ArthurPalladino/gigante-de-mdf/README.md

# gigante-de-mdf
O projeto gigante de MDF é um carrinho de batalha equipado com um laser como arma, capaz de detectar dano através de um LDR. Todo o sistema foi desenvolvido em C, utilizando um microcontrolador ATmega328P para controlar as funções do carrinho.
