ArthurPalladino/gigante-de-mdf/gigantes_mdf_pcb/gigantes_mdf.kicad_pcb

## KiCad design gigantes_mdf_pcb/gigantes_mdf.kicad_pcb (2025-11-25)

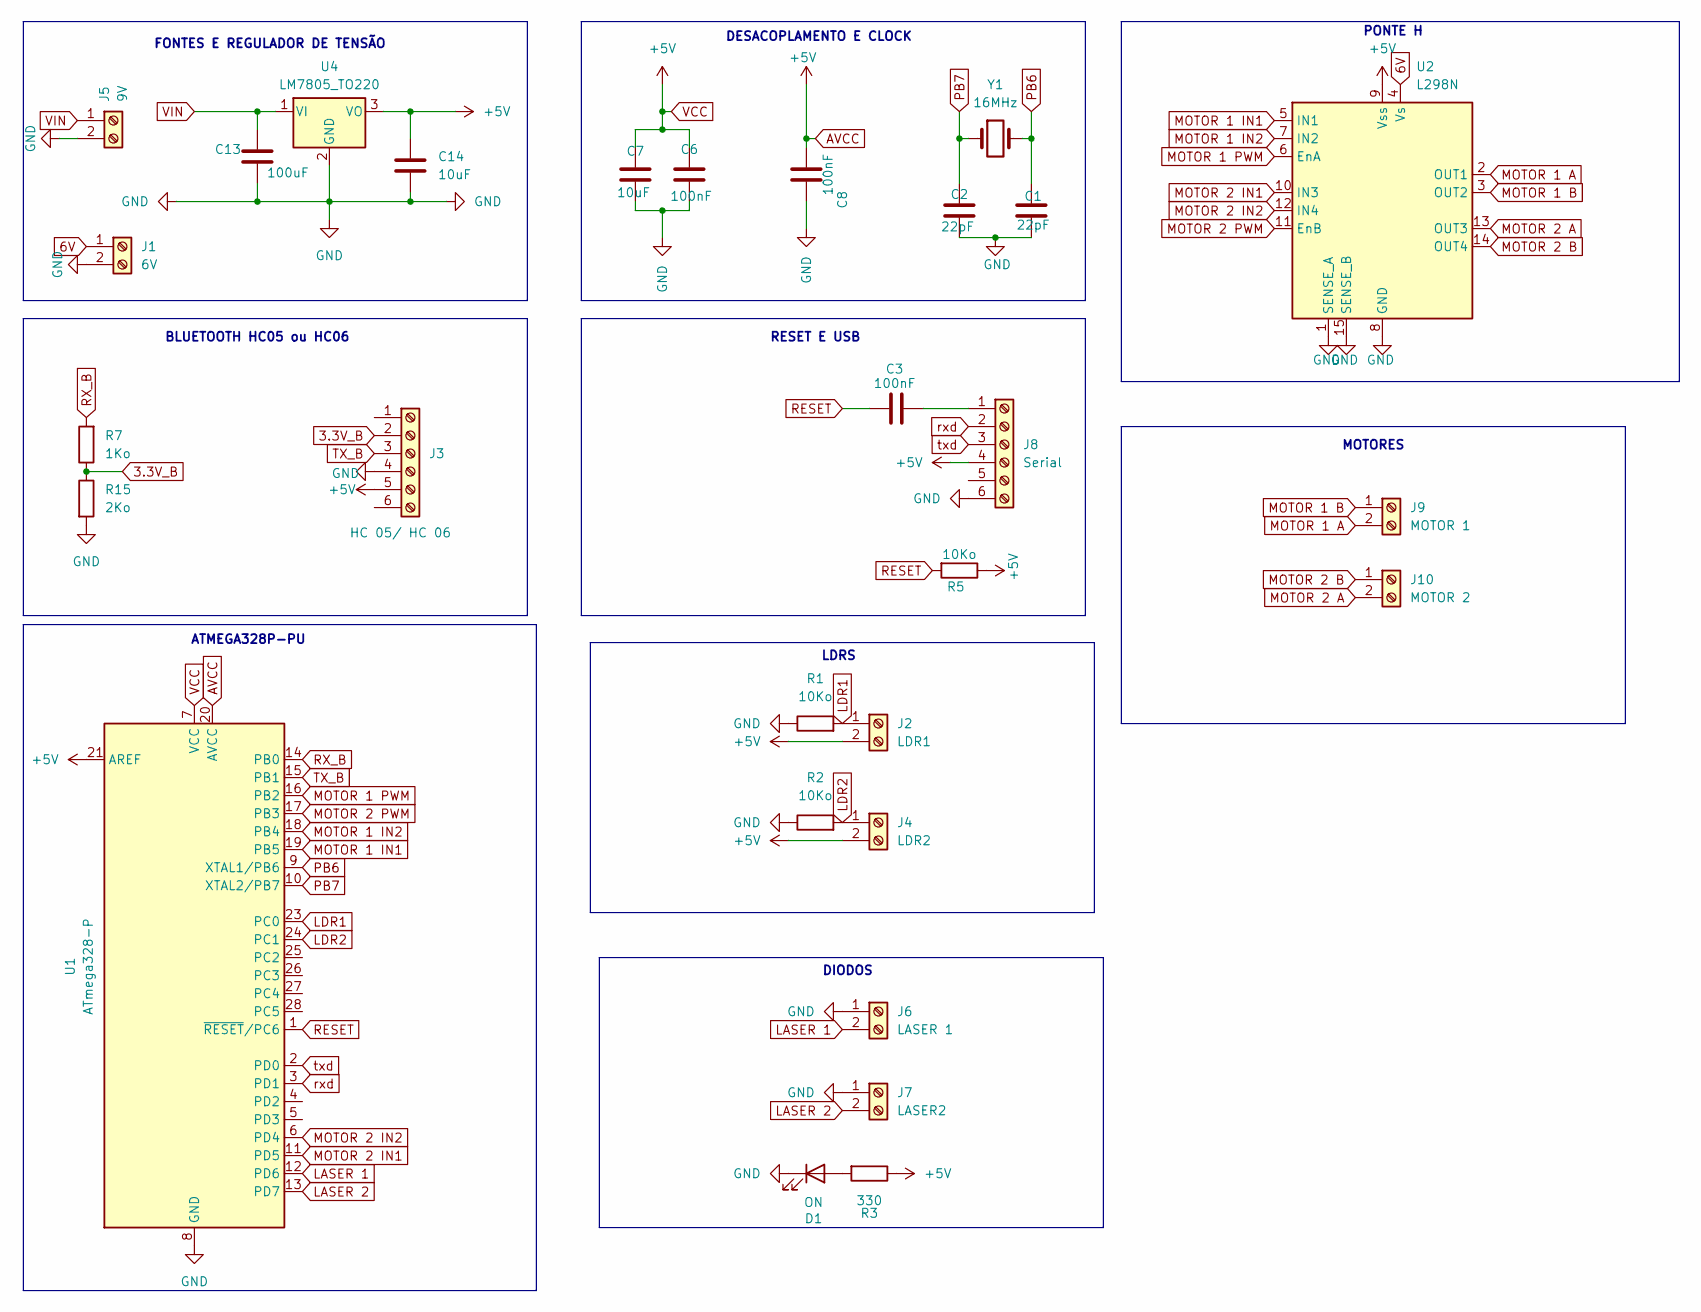
[picture p1: schematic gigantes_mdf.kicad_sch]

Parts:
C1, C2: 22pF; CP_Radial_Tantal_D5.5mm_P2.50mm
C3, C6, C8: 100nF; CP_Radial_Tantal_D5.5mm_P2.50mm
C7: 10uF; CP_Radial_Tantal_D5.5mm_P2.50mm
C13: 100uF; CP_Radial_D6.3mm_P2.50mm
C14: 10uF; CP_Radial_D6.3mm_P2.50mm
D1: ON; LED_D3.0mm_Horizontal_O1.27mm_Z10.0mm
J1: 6V; TerminalBlock_MaiXu_MX126-5.0-02P_1x02_P5.00mm
J2: LDR1; TerminalBlock_MaiXu_MX126-5.0-02P_1x02_P5.00mm
J3: HC 05/ HC 06; PinHeader_1x06_P2.54mm_Vertical
J4: LDR2; TerminalBlock_MaiXu_MX126-5.0-02P_1x02_P5.00mm
J5: 9V; TerminalBlock_MaiXu_MX126-5.0-02P_1x02_P5.00mm
J6: LASER 1; TerminalBlock_MaiXu_MX126-5.0-02P_1x02_P5.00mm
J7: LASER2; TerminalBlock_MaiXu_MX126-5.0-02P_1x02_P5.00mm
J8: Serial; PinHeader_1x06_P2.54mm_Vertical
J9: MOTOR 1; TerminalBlock_MaiXu_MX126-5.0-02P_1x02_P5.00mm
J10: MOTOR 2; TerminalBlock_MaiXu_MX126-5.0-02P_1x02_P5.00mm
R1, R2, R5: 10Ko; R_Axial_DIN0207_L6.3mm_D2.5mm_P10.16mm_Horizontal
R3: 330; R_Axial_DIN0207_L6.3mm_D2.5mm_P10.16mm_Horizontal
R7: 1Ko; R_Axial_DIN0207_L6.3mm_D2.5mm_P10.16mm_Horizontal
R15: 2Ko; R_Axial_DIN0207_L6.3mm_D2.5mm_P10.16mm_Horizontal
U1: ATmega328-P; DIP-28_W7.62mm
U2: L298N; TO-220-15_P2.54x5.08mm_StaggerOdd_Lead4.58mm_Vertical
U4: LM7805_TO220; TO-220-3_Vertical
Y1: 16MHz; Crystal_HC52-6mm_Vertical

Connections:
3.3V_B: J3.2, R7.1, R15.1
6V: J1.1, U2.4 (Vs)
AVCC: C6.1, C7.1, C8.2, C14.1, J2.2, J3.5, J4.2, J8.4, R3.1, R5.1, U1.7 (VCC), U1.20 (AVCC), U1.21 (AREF), U2.9 (Vss), U4.3 (VO)
GND: C1.2, C2.2, C6.2, C7.2, C8.1, C13.2, C14.2, D1.1 (K), J1.2, J3.4, J5.2, J6.1, J7.1, J8.6, R1.1, R2.1, R15.2, U1.8 (GND), U1.22 (GND), U2.1 (SENSE_A), U2.8 (GND), U2.15 (SENSE_B), U4.2 (GND)
LASER 1: J6.2, U1.12 (PD6)
LASER 2: J7.2, U1.13 (PD7)
LDR1: J2.1, R1.2, U1.23 (PC0)
LDR2: J4.1, R2.2, U1.24 (PC1)
MOTOR 1 A: J9.2, U2.2 (OUT1)
MOTOR 1 B: J9.1, U2.3 (OUT2)
MOTOR 1 IN1: U1.19 (PB5), U2.5 (IN1)
MOTOR 1 IN2: U1.18 (PB4), U2.7 (IN2)
MOTOR 1 PWM: U1.16 (PB2), U2.6 (EnA)
MOTOR 2 A: J10.2, U2.13 (OUT3)
MOTOR 2 B: J10.1, U2.14 (OUT4)
MOTOR 2 IN1: U1.11 (PD5), U2.10 (IN3)
MOTOR 2 IN2: U1.6 (PD4), U2.12 (IN4)
MOTOR 2 PWM: U1.17 (PB3), U2.11 (EnB)
unnamed: D1.2 (A), R3.2
unnamed: C3.2, J8.1
PB6: C1.1, U1.9 (XTAL1/PB6), Y1.2
PB7: C2.1, U1.10 (XTAL2/PB7), Y1.1
RESET: C3.1, R5.2, U1.1 (~RESET/PC6)
RX_B: R7.2, U1.14 (PB0)
TX_B: J3.3, U1.15 (PB1)
VIN: C13.1, J5.1, U4.1 (VI)
rxd: J8.2, U1.3 (PD1)
txd: J8.3, U1.2 (PD0)

Notes on the sheet:
PONTE H
ATMEGA328P-PU
LDRS
DIODOS
RESET E USB
MOTORES
DESACOPLAMENTO E CLOCK
BLUETOOTH HC05 ou HC06
FONTES E REGULADOR DE TENSÃO

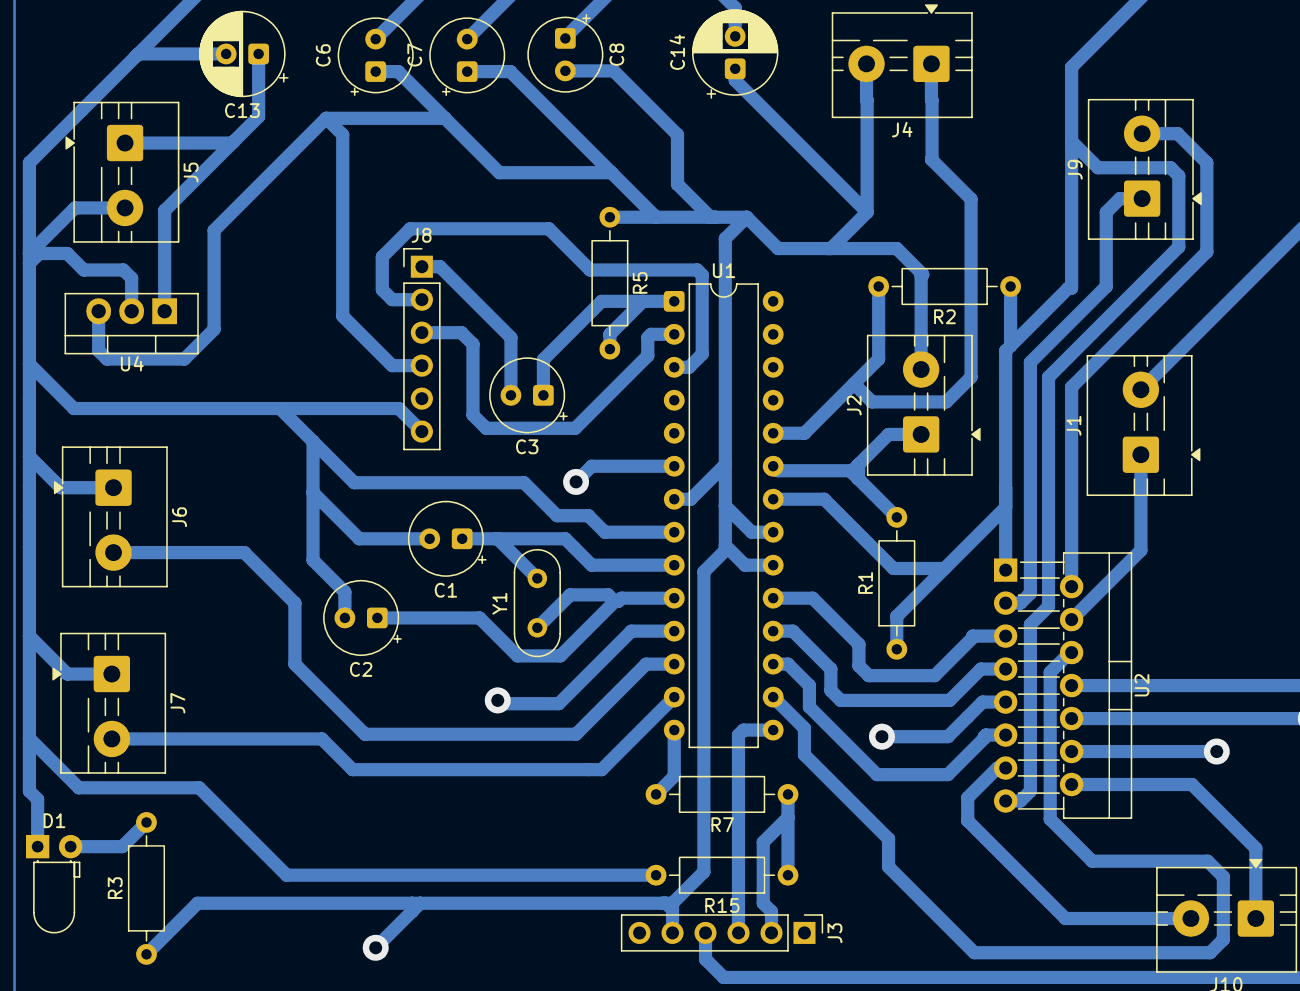
[picture p2: board gigantes_mdf.kicad_pcb from above]

Board: 2 copper layers, 29 parts (0 on the bottom side), 28 nets.
