ArthurPalladino/gigante-de-mdf/(commit log)

2025-11-25 Add complete pcb project and start new c file
    [gigantes_mdf.kicad_pcb, gigantes_mdf.kicad_sch]
2025-11-28 feat: uart serial and blutooth serial
2025-11-28 fix: update todo list
    [main.c]
2025-11-28 feat: life led handler and laser handler
2025-11-29 fix: ldr threshold, 180 degrees turn over and reset life statement
    [main.c]
